ACwing-UAV/ACwing_Mechs/02 - Mounts/Motor_Sleeves/README.md

# Motor sleeves

`ACwing_Motor_Sleeve_A1_x4.stl` holds 4 TPU 95A snap sleeves for 8.5 mm coreless motors (8520), in the assembly positions
(motors at RM 52 since 2026-11-08; the sleeve itself is unchanged). The print copy, on z = 0, is written by the Mech A1
macro. The sleeves snap into the frame A1 motor holders. Their bead locks into the holder groove.
