ACwing-UAV/ACwing_Mechs/00 - Docs/00 - Mech_A1_Docs/ACwing_Mech_A1_BoM.csv

Item | Group | Part | Specification | Material / standard | File / source | Unit mass (g) | Mass basis | Qty T400 | Qty T800 | Qty T1200 | Qty GPS add-on | Notes
P1 | Printed | Frame A1 core | 134.8 x 134.8 x 32.5 mm, motors at RM 52; rev R (2026-11-13): one body redrawn from a parametric plan (deck, stack bosses with ribs to the rails, rails with raised top and rounded ends, tray lugs, arms, motor holders), 4 wave prop guards (0.86 mm wall bulged 1.2 mm outward, 15 windows, 45 deg ramps with a 1.2 mm rim), spokes flush with the rims, one-piece motor holders with foot ring (z -30) and wire channel, 3 teardrop wire holes per arm and one through the rail, deck with the cable C slot | PETG | ACwing_Mech_A1_01_Frame_core_PETG.stl | 18.099 | mesh volume x 1.27 g/cm3 | 1 | 1 | 1 | 0 | print upside down (guard top edges on the bed): guards and spokes need no support; rev R 2026-11-13
P2 | Printed | Battery tray T400 | 400 mAh 1S, 20 x 40 x 8 pack; carries the flow board (turned 90 deg, connectors to +X) | PETG | ACwing_Mech_A1_02_Tray_T400_PETG.stl | 3.3 | mesh volume x 1.27 g/cm3 | 1 | 0 | 0 | 0 | one tray per flight; spare trays optional
P3 | Printed | Battery tray T800 | 800 mAh 1S, 25 x 45 x 9 pack | PETG | ACwing_Mech_A1_02_Tray_T800_PETG.stl | 3.546 | mesh volume x 1.27 g/cm3 | 0 | 1 | 0 | 0
P4 | Printed | Battery tray T1200 | 1200 mAh 1S, 30 x 64 x 8 pack | PETG | ACwing_Mech_A1_02_Tray_T1200_PETG.stl | 4.044 | mesh volume x 1.27 g/cm3 | 0 | 0 | 1 | 0
P5 | Printed | Stack spacer S1 | OD 4.5 / ID 2.3 x 2.57 mm (ESC top -> lower damping ball) | PETG | ACwing_Mech_A1_03_Stack_Spacers_S1x4_S2x4_PETG.stl | 0.038 | volume x 1.27 g/cm3 | 4 | 4 | 4 | 0 | 1.0 mm boards (2.8 mm with the 1.6 mm boards); the print file holds 4 x S1 + 4 x S2
P6 | Printed | Stack spacer S2 | OD 4.5 / ID 2.3 x 3.57 mm (upper damping ball -> GPS bottom) | PETG | ACwing_Mech_A1_03_Stack_Spacers_S1x4_S2x4_PETG.stl | 0.053 | volume x 1.27 g/cm3 | 0 | 0 | 0 | 4 | GPS option only (3.8 mm with the 1.6 mm boards)
P7 | Printed | Motor sleeve | snap sleeve for 8.5 mm coreless motor, in the frame holder | TPU 95A | ACwing_Mech_A1_04_Motor_Sleeves_x4_TPU95A.stl | 0.545 | mesh volume x 1.21 g/cm3 | 4 | 4 | 4 | 0 | the print file holds 4 sleeves
P8 | Printed | Electronics cover, indoor | canopy 52 x 52 mm (board axes) with concave sides (28 mm from the motor axes), flat roof (top z 11.3) with a 1.8 mm 45 deg chamfer, wavy skirt (z 6.2 at the corners, 9.0 at the side centres), wall/roof 0.8, USB-C notch, ACwing logo 24 mm engraved 0.4 mm | PLA translucent | ACwing_Mech_A1_05_Cover_indoor_PLA.stl | 2.789 | mesh volume x 1.24 g/cm3 | 1 | 1 | 1 | -1 | sits on the 4 upper damping balls; held by the 4 stack screws; FC corner LEDs visible under the skirt
P9 | Printed | Electronics cover, GPS | as P8, roof top z 21.25, skirt 6.2 / 17.0, posts on the GPS board (3.8 mm foot past GPS J1 / J2) | PLA translucent | ACwing_Mech_A1_05_Cover_GPS_PLA.stl | 4.274 | mesh volume x 1.24 g/cm3 | 0 | 0 | 0 | 1 | GPS option only (replaces P8)
P10 | Printed | Flow board cover | covers the sensor side of ACwing Flow rev A: 0.8 mm plate 0.3 mm under the PMW3901, 0.8 mm walls on three sides up to the board back, openings only for the PMW3901 lens (6 mm), the VL53L1X window (3.0 x 5.4) and the status LED; connector edge open for J1 / J2; one part for every tray | PETG (black or grey) | ACwing_Mech_A1_06_Flow_cover_PETG.stl | 0.672 | mesh volume x 1.27 g/cm3 | 1 | 1 | 1 | 0 | held by the two flow screws (H9); new 2026-11-13
H1 | Hardware | Hot-melt insert M2 (stack bosses) | M2 x 3 x OD 3.0, seat 2.8 x 3.4 (z -2.0 -> -5.0) | Brass, Hangtife HLTI-M2-001 | - | 0.1 | estimate | 4 | 4 | 4 | 0 | set with a soldering iron, 220-240 C
H2 | Hardware | Hot-melt insert M2 (tray lugs) | M2 x 3 x OD 3.0, open downwards | Brass, Hangtife HLTI-M2-001 | - | 0.1 | estimate | 4 | 4 | 4 | 0
H3 | Hardware | Hot-melt insert M2 (flow bosses) | M2 x 3 x OD 3.0, in each tray | Brass, Hangtife HLTI-M2-001 | - | 0.1 | estimate | 2 | 2 | 2 | 0 | 2 more for every spare tray
H4 | Hardware | Damping ball M2 (FC soft mount) | H 6.0, OD 4.9, slot OD 3.03 x 1.14 (1.0 mm board, Ø3.2 holes), bore 2.0; 2.43 mm above / below the board | Rubber, QUARKZMAN M2 anti-vibration ball | - | 0.1 | estimate | 4 | 4 | 4 | 0 | back to the 1.0 mm boards (HW handoff 0.19): replaces the 1.6 mm silicone grommet
H5 | Hardware | Stack screw M2 x 14 | ISO 7380 button head (dk 3.5, k 1.1), from the cover top: cover - ball - FC - ball - S1 - ESC - insert; head seat z 9.4, tip z -4.6 (2.6 mm in the insert) | Titanium or A4 stainless (no steel / A2 near the compasses) | - | 0.24 | estimate (titanium) | 4 | 4 | 4 | -4 | indoor; replaced by H6 with the GPS option
H6 | Hardware | Stack screw M2 x 25 | ISO 7380 button head, from the GPS cover top: cover - GPS - S2 - ball - FC - ball - S1 - ESC - insert; head seat z 20.0, tip z -5.0 (3.0 mm in the insert) | Titanium or A4 stainless | - | 0.4 | estimate (titanium) | 0 | 0 | 0 | 4 | GPS option only
H8 | Hardware | Tray screw M2 x 5 | ISO 7380 button or socket head, from below into the lug inserts | A4 stainless or titanium | - | 0.2 | estimate (A4) | 4 | 4 | 4 | 0 | 2.4 mm engagement in the 3 mm insert
H9 | Hardware | Flow board screw M2 x 6 | pan head, from below through the flow cover standoffs and the board into the tray inserts; head 1.4 mm deep in the cover counterbore (Ø4.0) | Nylon (PA66) | - | 0.03 | estimate | 2 | 2 | 2 | 0 | M2 x 4 before the flow cover (2026-11-13)
B1 | Purchased | Battery 1S LiPo 400 mAh | 20 x 40 x 8 mm, JST-PH 2.0 lead | LiPo | - | 11.5 | user data | 1 | 0 | 0 | 0 | slides in from the rear, snap latch
B2 | Purchased | Battery 1S LiPo 800 mAh | 25 x 45 x 9 mm, JST-PH 2.0 lead | LiPo | - | 22.0 | estimate | 0 | 1 | 0 | 0
B3 | Purchased | Battery 1S LiPo 1200 mAh | 30 x 64 x 8 mm, JST-PH 2.0 lead | LiPo | - | 30.0 | estimate | 0 | 0 | 1 | 0
M1 | Purchased | Coreless motor 8520 | OD 8.5 x 20 mm, 2 CW + 2 CCW | - | reference mesh in 03 - Assembly/ACwing_Mech_A1 | 3.6 | value used in the vibration model | 4 | 4 | 4 | 0 | no connector: leads out of the holder floor hole, through the channel in the holder rib, woven through the 3 holes of the arm, then through the deck slot to the ESC pads (thread before soldering)
M2 | Purchased | Propeller 55 mm | 2 CW + 2 CCW; front pair green | PC / PP | reference mesh in 03 - Assembly/ACwing_Mech_A1 |  | weigh | 4 | 4 | 4 | 0 | propeller disc r 27.5; guard wall inner r 28.6 (29.8 at the bulge); motor axes at RM 52
W1 | Harness | Cable A, ESC J1 -> FC J2 | JST SH 1.0 8-pin, 1:1 (pin 1 -> pin 1), straight loop: wire 10 mm between the housings (8 mm minimum), make all 8 wires 10 mm | - | ACwing_HW |  | - | 1 | 1 | 1 | 0 | ESC J1 and FC J2 at the same (u, v) on the front edge: up right behind the plugs, the bundle leans 2.3 mm toward the board corner; 1.4 mm from the propeller disc, 4.5 mm from the frame (the guard is open there)
W2 | Harness | Cable C, FC J4 -> Flow J1 | Qwiic (JST SH 4-pin) 1:1, wires twisted; wire 48-51 mm between housings: make it 60 mm (all trays) | - | ACwing_HW |  | - | 1 | 1 | 1 | 0 | FC J4 right edge -> back along the edge -> deck slot behind the rear grommets -> down outside the tray rail -> Flow J1 (connector edge to +X). A standard 100 mm Qwiic also fits (slack under the plate)
W3 | Harness | Cable B, FC J3 -> GPS J1 | Qwiic 1:1, route 12.8 mm (GPS J1 right above FC J3): make it 15 mm | - | ACwing_HW |  | - | 0 | 0 | 0 | 1 | GPS option only
W4 | Harness | Battery pigtail D | JST-PH 2.0 on the ESC 1S pads across the rear-left corner (rotated 45 deg), 22 mm route: make both wires 25 mm | - | ACwing_HW |  | - | 1 | 1 | 1 | 0 | over the rear deck tip, down behind the tray; plug the pack after inserting it
