ACwing-UAV/ACwing_Mechs/00 - Docs/00 - Mech_A1_Docs/STEP/Parts/ACwing_Flow_Cover_A1.step

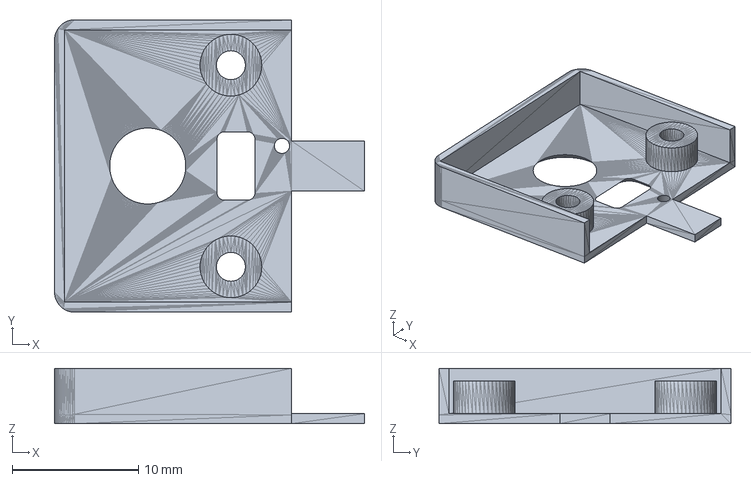
[picture p3: CAD file, 2026-11-14]
00 - Docs/00 - Mech_A1_Docs/STEP/Parts/ACwing_Flow_Cover_A1.step
24.6 x 23.2 x 4.40 mm
