ACwing-UAV/ACwing_Mechs/00 - Docs/00 - Mech_A1_Docs/STEP/Parts/ACwing_Cover_A1_indoor.step

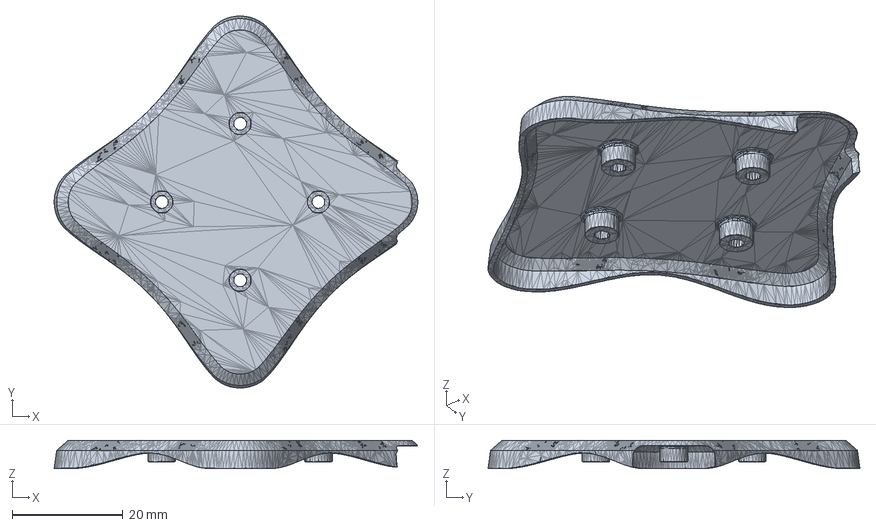
[picture p5: CAD file, 2026-11-13]
00 - Docs/00 - Mech_A1_Docs/STEP/Parts/ACwing_Cover_A1_indoor.step
65.7 x 67.2 x 5.10 mm
