ACwing-UAV/ACwing_Mechs/00 - Docs/00 - Mech_A1_Docs/STEP/ACwing_Mech_A1_T400_gps_hardware_cables.step

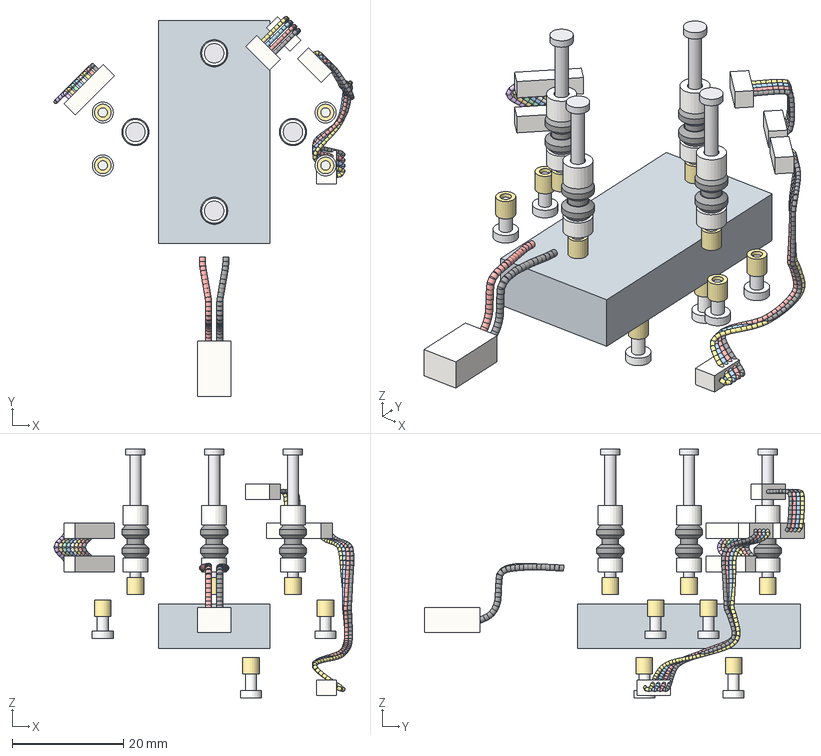
[picture p6: CAD file, 2026-11-14]
00 - Docs/00 - Mech_A1_Docs/STEP/ACwing_Mech_A1_T400_gps_hardware_cables.step
53.9 x 68.2 x 44.7 mm
