ACwing-UAV/ACwing_Mechs/00 - Docs/00 - Mech_A1_Docs/STEP/Parts/ACwing_Cover_A1_gps.step

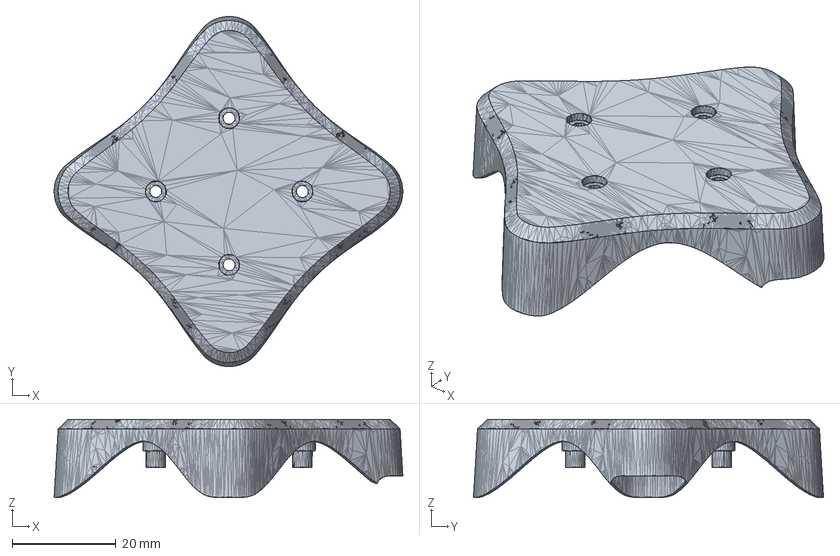
[picture p7: CAD file, 2026-11-13]
00 - Docs/00 - Mech_A1_Docs/STEP/Parts/ACwing_Cover_A1_gps.step
67.3 x 67.5 x 15.1 mm
