ACwing-UAV/ACwing_Mechs/00 - Docs/00 - Mech_A1_Docs/STEP/Parts/ACwing_Tray_A1_T400.step

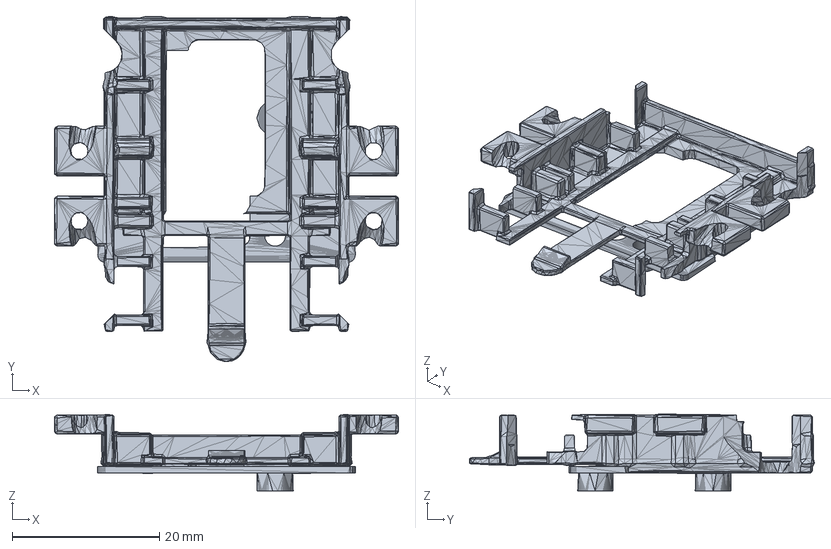
[picture p8: CAD file, 2026-11-08]
00 - Docs/00 - Mech_A1_Docs/STEP/Parts/ACwing_Tray_A1_T400.step
46.8 x 46.9 x 10.4 mm
