ACwing-UAV/ACwing_Mechs/00 - Docs/00 - Mech_A1_Docs/STEP/Parts/ACwing_Tray_A1_T800.step

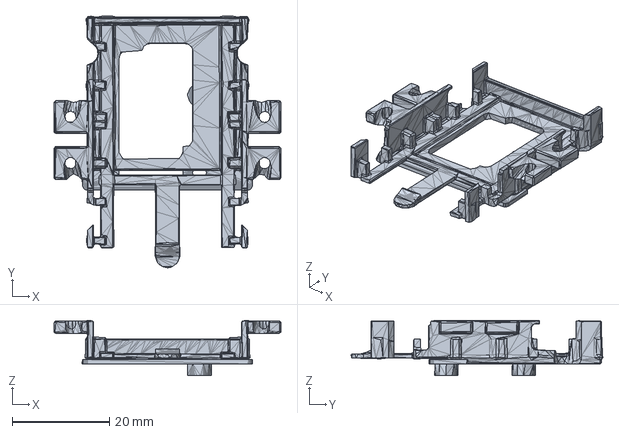
[picture p10: CAD file, 2026-11-08]
00 - Docs/00 - Mech_A1_Docs/STEP/Parts/ACwing_Tray_A1_T800.step
46.8 x 51.9 x 11.4 mm
