ACwing-UAV/ACwing_Mechs/(list of files, cad)

Other CAD files:
00 - Docs/00 - Mech_A1_Docs/Prints/ACwing_Mech_A1_01_Frame_core_PETG.stl
00 - Docs/00 - Mech_A1_Docs/STEP/Parts/ACwing_Frame_A1_core.step
01 - Frame/Frame_A1/ACwing_Frame_A1_core.3mf
02 - Mounts/Battery_Trays_A1/ACwing_Tray_A1_T400.stl
02 - Mounts/Electronics_Cover_A1/ACwing_Cover_A1_gps.stl
02 - Mounts/Flow_Cover_A1/ACwing_Flow_Cover_A1.stl
02 - Mounts/Motor_Sleeves/ACwing_Motor_Sleeve_A1_x4.stl
02 - Mounts/Stack_Spacers/ACwing_Stack_Spacers_A1_S1x4_S2x4.stl
03 - Assembly/ACwing_Mech_A1/reference/ACwing_Ref_motor_leads_x4.stl
00 - Docs/00 - Mech_A1_Docs/Prints/ACwing_Mech_A1_06_Flow_cover_PETG.stl
02 - Mounts/Battery_Trays_A1/ACwing_Tray_A1_T1200.stl
02 - Mounts/Electronics_Cover_A1/ACwing_Cover_A1_indoor.stl
03 - Assembly/ACwing_Mech_A1/reference/ACwing_Ref_props_55mm_front_x2.stl
00 - Docs/00 - Mech_A1_Docs/Prints/ACwing_Mech_A1_05_Cover_GPS_PLA.stl
02 - Mounts/Battery_Trays_A1/ACwing_Tray_A1_T800.stl
03 - Assembly/ACwing_Mech_A1/reference/ACwing_Ref_motors_8520_x4.stl
00 - Docs/00 - Mech_A1_Docs/Prints/ACwing_Mech_A1_05_Cover_indoor_PLA.stl
03 - Assembly/ACwing_Mech_A1/reference/ACwing_Ref_props_55mm_rear_x2.stl
00 - Docs/00 - Mech_A1_Docs/Prints/ACwing_Mech_A1_02_Tray_T1200_PETG.stl
00 - Docs/00 - Mech_A1_Docs/Prints/ACwing_Mech_A1_03_Stack_Spacers_S1x4_S2x4_PETG.stl
00 - Docs/00 - Mech_A1_Docs/Prints/ACwing_Mech_A1_04_Motor_Sleeves_x4_TPU95A.stl
00 - Docs/00 - Mech_A1_Docs/Prints/ACwing_Mech_A1_02_Tray_T400_PETG.stl
00 - Docs/00 - Mech_A1_Docs/Prints/ACwing_Mech_A1_02_Tray_T800_PETG.stl
01 - Frame/Frame_A1/ACwing_Frame_A1_core.stl
