ACwing-UAV/ACwing_Mechs/(commit log)

2026-10-31 Initial structure: README, Git LFS rules for CAD, .gitignore
    Claude-Session: https://claude.ai/code/session_01Td5hUdt9aKLnh1mFddNDQp
2026-11-01 Added first candidate, rev A, of the mechanics
    [ACwing_Frame_A_core.stl, ACwing_Mech_A_01_Frame_C3_core_PETG.stl, ACwing_Mech_A_02_Tray_C3_T1200_PETG.stl, ACwing_Mech_A_02_Tray_C3_T400_PETG.stl, ACwing_Mech_A_02_Tray_C3_T800_PETG.stl, ACwing_Mech_A_03_Stack_Spacers_S1x4_S2x4_PETG.stl, ACwing_Mech_A_04_Motor_Sleeves_x4_TPU95A.stl, ACwing_Mech_A_BoM.csv]
2026-11-01 Mechanics A1: rename from the preliminary drafts
    The current mechanics is A1; earlier frames are named only as "preliminary draft".
    - Folders and files: Mech_A -> Mech_A1, Frame_A -> Frame_A1, Battery_Trays_C3 -> Battery_Trays_A1,
    ACwing_<part>_A1_* names; macro ACwing_Mech_A1.FCMacro (+ _data.json)
    - Print files renamed (same content, written by FreeCAD); STEP and checks renamed
    - Docs, READMEs, BoM (xlsx/csv), handoff note: C2 -> preliminary draft, C3 -> A1;
    BoM harness items W1-W4
    - Renders regenerated with A1 captions
    Claude-Session: https://claude.ai/code/session_019Nr6Xnv8axshXV5pw79JDM
    [ACwing_Frame_A1_core.stl, ACwing_Mech_A1_01_Frame_core_PETG.stl, ACwing_Mech_A1_02_Tray_T1200_PETG.stl, ACwing_Mech_A1_02_Tray_T400_PETG.stl, ACwing_Mech_A1_02_Tray_T800_PETG.stl, ACwing_Mech_A1_03_Stack_Spacers_S1x4_S2x4_PETG.stl, ACwing_Mech_A1_04_Motor_Sleeves_x4_TPU95A.stl, ACwing_Mech_A1_BoM.csv]
2026-11-01 A1 renders and BoM
    [ACwing_Frame_A1_core.stl, ACwing_Mech_A1_01_Frame_core_PETG.stl, ACwing_Mech_A1_02_Tray_T1200_PETG.stl, ACwing_Mech_A1_02_Tray_T400_PETG.stl, ACwing_Mech_A1_02_Tray_T800_PETG.stl, ACwing_Mech_A1_03_Stack_Spacers_S1x4_S2x4_PETG.stl, ACwing_Mech_A1_04_Motor_Sleeves_x4_TPU95A.stl, ACwing_Mech_A1_BoM.csv]
2026-11-02 renamed assembly folder
    [ACwing_Mech_A1_01_Frame_core_PETG.stl, ACwing_Mech_A1_02_Tray_T1200_PETG.stl, ACwing_Mech_A1_02_Tray_T400_PETG.stl, ACwing_Mech_A1_02_Tray_T800_PETG.stl, ACwing_Mech_A1_03_Stack_Spacers_S1x4_S2x4_PETG.stl, ACwing_Mech_A1_04_Motor_Sleeves_x4_TPU95A.stl, ACwing_Mech_A1_T400_hardware_cables.step, ACwing_Ref_motor_leads_x4.stl]
2026-11-02 Docs and macro: assembly folder is 03 - Assembly
    - README structure: 03 - Assembly (the unused 03 - Prints entry is dropped:
    print files live in 00 - Docs/<release>_Docs/Prints)
    - Links and paths in the Mech A1 docs, the design note, the BoM CSV and the
    macro error message point to 03 - Assembly/ACwing_Mech_A1
    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
    [ACwing_Mech_A1_BoM.csv]
2026-11-02 BoM file updated
    [ACwing_Mech_A1_BoM.xlsx]
2026-11-06 Mech A1 for the rev A stack with 1.6 mm boards; electronics cover
    - Stack heights for 1.6 mm boards: FC 4.6, GPS 12.2; silicone grommets H 6 / groove 1.6;
    spacers S1 2.8, S2 3.8.
    - Electronics cover A1 (translucent PLA, indoor and GPS), ACwing logo on the roof;
    stack screws M2 x 16 / M2 x 25 ISO 7380 from the cover top.
    - Cables A and C rerouted for the 2026-11-02 connector layout (75 / 70 mm).
    - Macro: cover, grommets, screws from the data file, STEP per tray and config.
    - Assembly STEPs (hardware + cables) and faceted part STEPs (core, trays, covers).
    - BoM csv, handoff, READMEs.
    Claude-Session: https://claude.ai/code/session_019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
    [ACwing_Cover_A1_gps.step, ACwing_Cover_A1_indoor.step, ACwing_Frame_A1_core.step, ACwing_Mech_A1_BoM.csv, ACwing_Mech_A1_T1200_hardware_cables.step, ACwing_Mech_A1_T1200_indoor_hardware_cables.step, ACwing_Mech_A1_T400_gps_hardware_cables.step, ACwing_Mech_A1_T400_hardware_cables.step]
2026-11-06 Mech A1 rev A stack: assembly checks, cable A between the columns, GPS cover foot
    - Checks rerun (T400 indoor/GPS, T800, T1200): every pair 0 except the battery resting on the tray lips.
    - Cable A top run between the stack columns (it crossed the cover posts and the S2 spacers),
    rear corridor 0.6 mm inboard (FC J1 USB-C); 67-70 mm, make 75 mm.
    - GPS cover posts: 3.8 mm foot past GPS J1/J2 (5.4 g).
    - Macro data, assembly STEPs, GPS cover STEP, BoM csv, handoff section 9 (issue #2).
    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
    [ACwing_Cover_A1_gps.step, ACwing_Mech_A1_BoM.csv, ACwing_Mech_A1_T1200_indoor_hardware_cables.step, ACwing_Mech_A1_T400_gps_hardware_cables.step, ACwing_Mech_A1_T400_indoor_hardware_cables.step, ACwing_Mech_A1_T800_indoor_hardware_cables.step]
2026-11-07 Mech A1: ESC J1 on the front edge, motors at RM 53, new cable C and flow mount, weight study
    Answer to the ACwing_HW mechanical handoff 0.14 / 0.15 (2026-11-06):
    - ESC 1S J1 now on the front edge, under the front-left guard top ring: motors moved out
    to RM 53 (+2 mm) so cable A can rise behind the plug. Cable A is a 1:1 U-loop, 12 mm
    of wire (make 20 mm), 2.9 mm from the propeller disc.
    - Cable C: back along the FC right edge, through a new deck slot behind the rear
    grommets, down outside the tray rail into Flow J1 (49-53 mm, make 60 mm).
    - Flow board turned 90 deg, connector edge toward +X, optical axis on the frame centre;
    flow bosses at (6.6, +-8), tray plates extended to y -11.6.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
    [ACwing_Cover_A1_gps.step, ACwing_Cover_A1_indoor.step, ACwing_Frame_A1_core.step, ACwing_Mech_A1_BoM.csv, ACwing_Mech_A1_T1200_indoor_hardware_cables.step, ACwing_Mech_A1_T400_gps_hardware_cables.step, ACwing_Mech_A1_T400_indoor_hardware_cables.step, ACwing_Mech_A1_T800_indoor_hardware_cables.step]
2026-11-07 Mech A1: ESC J1 toward the front corner -> motors back at RM 51; drone render in the README
    - ACwing_HW esc-j1-corner (handoff 0.17): ESC 1S J1 at (+13.3, +16.08). Cable A now clears
    the front-left guard ring by 0.42 mm at RM 51, so the RM 53 change is dropped: frame
    131.5 mm, core 14.95 g, first mode 127 Hz with T400 (121 Hz at RM 53).
    - Cable A 15.4 mm of wire (make 20 mm), 9.7 mm shift in the upper half; cable C slot
    moved to u 20.5-23.7, v -13.5...-10.1, clearances >= 0.49 mm.
    - Checks rerun (T400 indoor/GPS, T800, T1200): all 0 except the battery on the lips.
    - Data, STEPs, BoM, handoff 10, weight study (net -2.2 g), READMEs.
    - README: KiCad raytracer render of the drone at the to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
    [ACwing_Frame_A1_core.step, ACwing_Mech_A1_BoM.csv, ACwing_Mech_A1_T1200_indoor_hardware_cables.step, ACwing_Mech_A1_T400_gps_hardware_cables.step, ACwing_Mech_A1_T400_indoor_hardware_cables.step, ACwing_Mech_A1_T800_indoor_hardware_cables.step]
2026-11-08 commit to LFS for big files
    [ACwing_Cover_A1_gps.stl, ACwing_Cover_A1_indoor.stl, ACwing_Mech_A1_03_Stack_Spacers_S1x4_S2x4_PETG.stl, ACwing_Mech_A1_05_Cover_GPS_PLA.stl, ACwing_Mech_A1_05_Cover_indoor_PLA.stl, ACwing_Mech_A1_BoM.xlsx, ACwing_Stack_Spacers_A1_S1x4_S2x4.stl]
2026-11-08 Mech A1: A2 guard rings, motors at RM 52, 1.0 mm stack, new cover
    Answer to the ACwing_HW mechanical handoff §0.19-§0.20 (boards back to 1.0 mm,
    ESC J1 at (-10.5, +16.85)):
    - A2 guard rings on all four motors: top ring only on the outer half, ramps
    1.2 x 1.7 mm down to the bottom ring at +-32 deg, inner ribs and top bridges
    removed (guard-ring study: -1.4 Hz first mode, -0.17 g, side stiffness kept)
    - motors at RM 52 (frame 132.9 mm): cable A 1.37 mm from the propeller disc
    - stack for 1.0 mm boards: QUARKZMAN M2 damping balls, S1 2.57 / S2 3.57 mm,
    stack screws M2 x 14 (indoor) / M2 x 25 (GPS), flow screws M2 x 4
    - cables: A straight loop 10 mm, B 15 mm, C 60 mm, D 25 mm
    - new elect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
    [ACwing_Cover_A1_gps.step, ACwing_Cover_A1_indoor.step, ACwing_Frame_A1_core.step, ACwing_Mech_A1_BoM.csv, ACwing_Mech_A1_T1200_indoor_hardware_cables.step, ACwing_Mech_A1_T400_gps_hardware_cables.step, ACwing_Mech_A1_T400_indoor_hardware_cables.step, ACwing_Mech_A1_T800_indoor_hardware_cables.step]
2026-11-08 Commited the LFS files for the new mechs revision
    [ACwing_Cover_A1_gps.stl, ACwing_Cover_A1_indoor.stl, ACwing_Frame_A1_core.stl, ACwing_Mech_A1_01_Frame_core_PETG.stl, ACwing_Mech_A1_02_Tray_T1200_PETG.stl, ACwing_Mech_A1_02_Tray_T400_PETG.stl, ACwing_Mech_A1_02_Tray_T800_PETG.stl, ACwing_Mech_A1_03_Stack_Spacers_S1x4_S2x4_PETG.stl]
2026-11-12 Mech A1: print-first frame (wave guards, closed wire eyelets, flat-roof cover)
    The first print of the A2 core (PETG Matte, upside down) failed: the guard top
    rings needed supports and broke when they were removed. Redesign for a Bambu
    Lab A1 with no supports inside the guards (handoff §12):
    - wave guards: 0.86 mm wall bulged 1.2 mm outward, top lip, lower rim and a
    2.2 mm S ribbon between them (cover-skirt curve), 15 windows with sills at
    45 deg or 6.2 mm bridges, 45 deg ramps with a 1.2 mm rim, open toward the body;
    - straight spokes at the lower-rim level; 12 closed wire eyelets on the arms
    (motors have no connector);
    - cover: flat roof, 45 deg chamfer, engraved logo, prints roof-do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
    [ACwing_Cover_A1_gps.step, ACwing_Cover_A1_indoor.step, ACwing_Frame_A1_core.step, ACwing_Mech_A1_BoM.csv, ACwing_Mech_A1_T1200_indoor_hardware_cables.step, ACwing_Mech_A1_T400_gps_hardware_cables.step, ACwing_Mech_A1_T400_indoor_hardware_cables.step, ACwing_Mech_A1_T800_indoor_hardware_cables.step]
2026-11-13 Mech A1: one-piece motor holders, foot ring and wire channel, aligned spokes
    Fixes from the slicer review of the 2026-11-12 core (handoff §13):
    - motor holder rebuilt as one body (the collar was a separate body touching
    the old holder: non-manifold edges); 45 deg top chamfer, snap windows kept;
    - landing loop replaced by an L1 foot ring (frame 36.4 -> 28.0 mm tall);
    motor leads: floor hole -> recess -> closed channel in a rib under the arm
    -> 3 teardrop holes in the arm blade -> deck slot;
    - spokes flush with the lower rim, 45 deg gussets, no stub outside the guard;
    bridges with the rim section, in line with the +-45 deg spokes;
    - arm roots remeshed (seam and stair steps of the pod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
    [ACwing_Frame_A1_core.step, ACwing_Mech_A1_BoM.csv]
2026-11-13 Added the BumbuStudio 3mf project for Frame core
    [ACwing_Frame_A1_core.3mf]
2026-11-13 Mech A1 rev R (WIP): flow board cover README, macro with the flow cover
    Macro: flow cover A1 in the assembly (follows the tray), M2 x 6 nylon flow
    screws from below, cover print files roof-down, new print file 06 (flow
    cover, plate on the bed). The rev R core, data and docs follow.
    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
2026-11-13 Mech A1 rev R: core regenerated from a parametric plan, flow board cover
    The core is no longer edited from the 2026-11-07 mesh: it is generated from
    scratch (plan first, then 3D) as one smooth body - deck, stack bosses, deck
    ribs, side rails with round caps, tray lugs, arms - fused with the exact motor
    holders, wave guards, spokes and bridges; holes cut last. No leftovers of
    earlier booleans, 0 non-manifold edges after the STL round trip (the Bambu
    Studio errors came from pinch points in the guard outline and shared faces).
    - ring beam under the stack: deck ribs boss -> rails, rails raised and flared
    toward the arm roots; no knee braces / side spars
    - holder foot at z -30 (frame 32.5 mm):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
    [ACwing_Flow_Cover_A1.step, ACwing_Frame_A1_core.step, ACwing_Mech_A1_BoM.csv, ACwing_Mech_A1_T1200_indoor_hardware_cables.step, ACwing_Mech_A1_T400_gps_hardware_cables.step, ACwing_Mech_A1_T400_indoor_hardware_cables.step, ACwing_Mech_A1_T800_indoor_hardware_cables.step]
2026-11-13 Handoff §14: underside render with the flow board cover
    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
2026-11-13 Mech A1 rev R: motor leads on the new route (renders, checks, docs)
    The reference motor-lead mesh follows the rev R route: floor hole, rib
    channel, teardrop exit, 3 arm holes, once under the blade at the root,
    rail-cap hole, deck slot, ESC pads (83-85 mm per wire). Checks rerun:
    0 unexpected overlaps; the leads no longer cross the core. Build order
    and handoff section 14 describe the route. Mesh and renders (Git LFS) in
    the delivery zip.
    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
2026-11-14 Mech A1 rev R docs: guard bead, flush 45 deg spokes, lead exit flipped
    Handoff section 14 and READMEs describe the 2026-11-14 clean-up: the
    ±45 deg spokes end flush with the lower rim (in line with the bridges),
    the guard ramp edges are one swept bead with the lip section, and the
    rib lead exit moved to the other side so the leads no longer wrap under
    the arm. Core, data and checks follow after verification.
    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
2026-11-14 Mech A1 rev R: core outputs after the 2026-11-14 clean-up
    Core regenerated with the swept guard bead, flush ±45 deg spokes and the
    flipped rib lead exit (18.10 g; T400 90.4 / 139.7 Hz; motor thrust
    1.00 mm). Checks rerun with the new lead route: 0 unexpected overlaps.
    Data, BoM csv, FE / checks JSON, core and assembly STEP updated; STL and
    renders (Git LFS) in the delivery zip.
    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
    [ACwing_Frame_A1_core.step, ACwing_Mech_A1_BoM.csv, ACwing_Mech_A1_T1200_indoor_hardware_cables.step, ACwing_Mech_A1_T400_gps_hardware_cables.step, ACwing_Mech_A1_T400_indoor_hardware_cables.step, ACwing_Mech_A1_T800_indoor_hardware_cables.step]
